bryanduxbury/charlieclocks/(list of files, cad)

Other CAD files:
radiata/v1/enclosure_v1.scad
