bryanduxbury/charlieclocks/radiata/v2/prog_adapter.brd

## EAGLE design radiata/v2/prog_adapter.brd (2013-12-31)

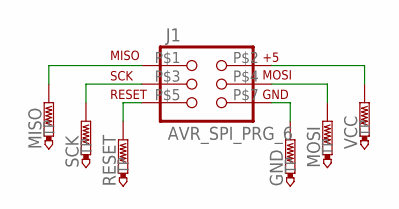
[picture p1: schematic prog_adapter.sch]

Parts:
GND: PTR1PAD1-17; P1-17
J1: AVR_SPI_PRG_6; 2X3_ICSP_SMD
MISO: PTR1PAD1-17; P1-17
MOSI: PTR1PAD1-17; P1-17
RESET: PTR1PAD1-17; P1-17
SCK: PTR1PAD1-17; P1-17
VCC: PTR1PAD1-17; P1-17

Connections:
unnamed: J1.P$1 (1), MISO.TP
unnamed: J1.P$3 (3), SCK.TP
unnamed: J1.P$5 (5), RESET.TP
unnamed: J1.P$2 (2), VCC.TP
unnamed: J1.P$4 (4), MOSI.TP
unnamed: GND.TP, J1.P$7 (6)

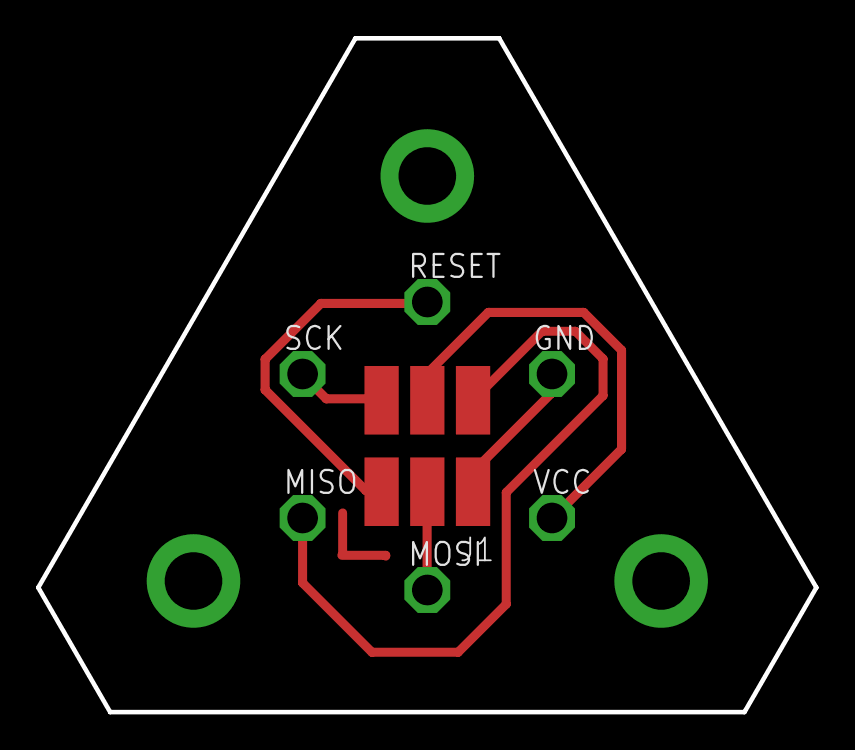
[picture p2: board prog_adapter.brd from above]

Board: 2 copper layers, 43.2 x 37.4 mm, 7 parts (0 on the bottom side), 6 nets.
