bryanduxbury/charlieclocks/radiata/v2/radiata_v2.brd

## EAGLE design radiata/v2/radiata_v2.brd (2014-02-02)

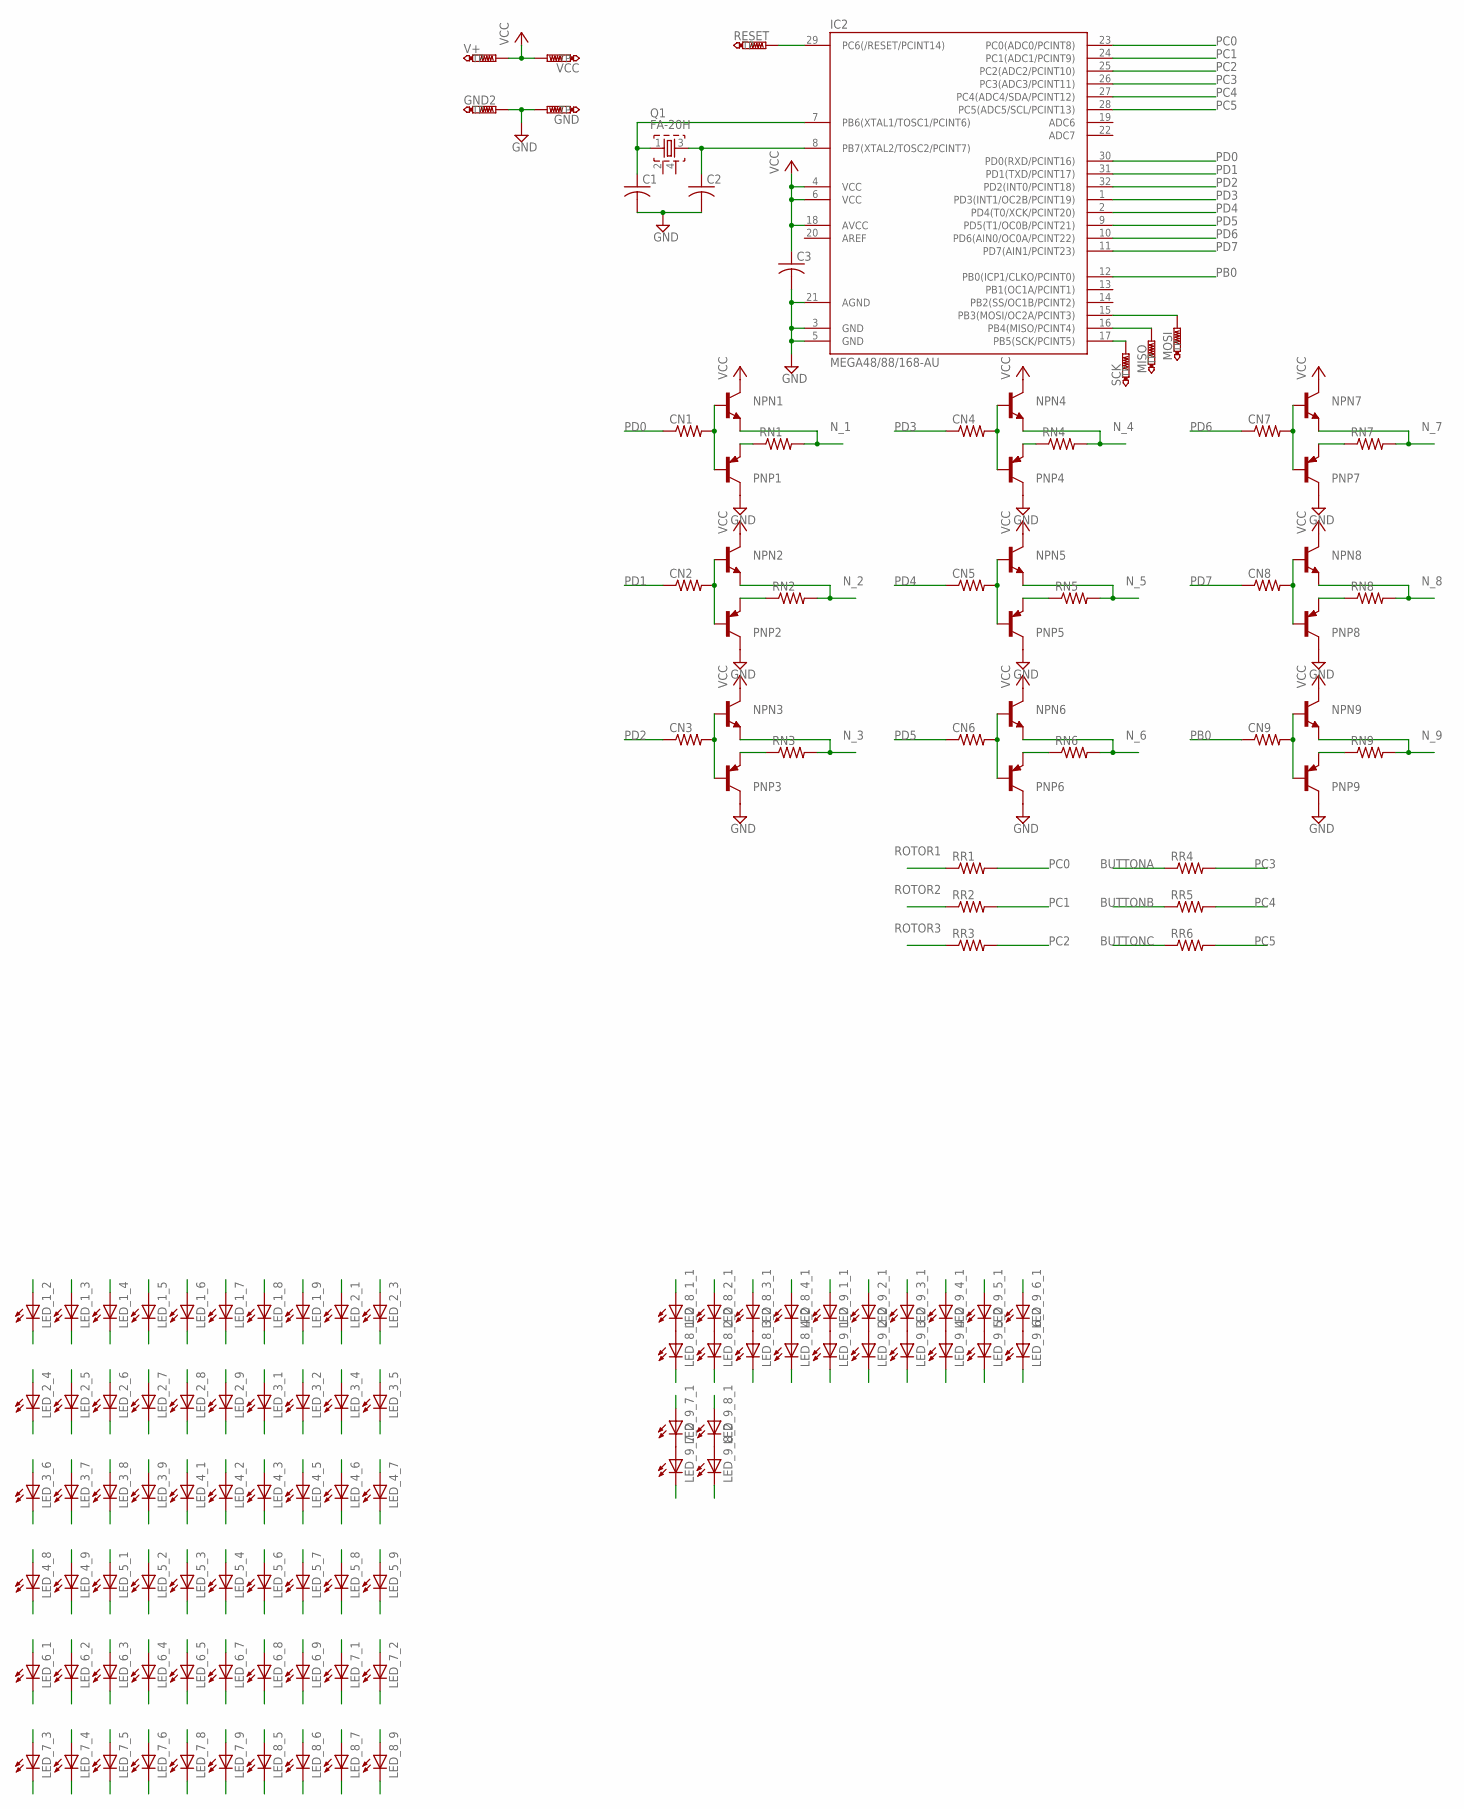
[picture p3: schematic radiata_v2.sch]

Parts:
C1, C2, C3: C-USC0603; C0603
CN1, CN2, CN3, CN4, CN5, CN6, CN7, CN8, CN9: R-US_M0805; M0805
GND: PTR1TP19R; TP19R
GND2: PTR1TP20SQ; TP20SQ
IC2: MEGA48/88/168-AU; TQFP32-08
LED_1_2, LED_1_3, LED_1_4, LED_1_5, LED_1_6, LED_1_7, LED_1_8, LED_1_9, LED_2_1, LED_2_3, LED_2_4, LED_2_5, LED_2_6, LED_2_7, LED_2_8, LED_2_9, LED_3_1, LED_3_2, LED_3_4, LED_3_5, LED_3_6, LED_3_7, LED_3_8, LED_3_9, LED_4_1, LED_4_2, LED_4_3, LED_4_5, LED_4_6, LED_4_7, LED_4_8, LED_4_9, LED_5_1, LED_5_2, LED_5_3, LED_5_4, LED_5_6, LED_5_7, LED_5_8, LED_5_9, LED_6_1, LED_6_2, LED_6_3, LED_6_4, LED_6_5, LED_6_7, LED_6_8, LED_6_9, LED_7_1, LED_7_2, LED_7_3, LED_7_4, LED_7_5, LED_7_6, LED_7_8, LED_7_9, LED_8_1_1, LED_8_1_2, LED_8_2_1, LED_8_2_2, LED_8_3_1, LED_8_3_2, LED_8_4_1, LED_8_4_2, LED_8_5, LED_8_6, LED_8_7, LED_8_9, LED_9_1_1, LED_9_1_2, LED_9_2_1, LED_9_2_2, LED_9_3_1, LED_9_3_2, LED_9_4_1, LED_9_4_2, LED_9_5_1, LED_9_5_2, LED_9_6_1, LED_9_6_2, LED_9_7_1, LED_9_7_2, LED_9_8_1, LED_9_8_2: LED1206; LED-1206
MISO: PTR1TP19R; TP19R
MOSI: PTR1TP19R; TP19R
NPN1, NPN2, NPN3, NPN4, NPN5, NPN6, NPN7, NPN8, NPN9: MMBT2222ALT1-NPN-SOT23-BEC; SOT23-BEC
PNP1, PNP2, PNP3, PNP4, PNP5, PNP6, PNP7, PNP8, PNP9: MMBT2907ALT1-PNP-SOT23-BEC; SOT23-BEC
Q1: FA-20H
RESET: PTR1TP19R; TP19R
RN1, RN2, RN3, RN4, RN5, RN6, RN7, RN8, RN9: RESISTOR1206; 1206
RR1, RR2, RR3, RR4, RR5, RR6: RESISTOR1206; 1206
SCK: PTR1TP19R; TP19R
V+: PTR1TP20SQ; TP20SQ
VCC: PTR1TP19R; TP19R

Connections:
BUTTONA: RR4.1
BUTTONB: RR5.1
BUTTONC: RR6.1
GND: C1.2, C2.2, C3.2, GND.TP, GND2.TP, IC2.3 (GND), IC2.5 (GND), IC2.21 (AGND), PNP1.C, PNP2.C, PNP3.C, PNP4.C, PNP5.C, PNP6.C, PNP7.C, PNP8.C, PNP9.C
unnamed: IC2.29 (PC6(/RESET/PCINT14)), RESET.TP
unnamed: IC2.17 (PB5(SCK/PCINT5)), SCK.TP
unnamed: IC2.16 (PB4(MISO/PCINT4)), MISO.TP
unnamed: IC2.15 (PB3(MOSI/OC2A/PCINT3)), MOSI.TP
unnamed: PNP1.E, RN1.1
unnamed: CN1.2, NPN1.B, PNP1.B
unnamed: PNP2.E, RN2.1
unnamed: CN2.2, NPN2.B, PNP2.B
unnamed: PNP3.E, RN3.1
unnamed: CN3.2, NPN3.B, PNP3.B
unnamed: PNP4.E, RN4.1
unnamed: CN4.2, NPN4.B, PNP4.B
unnamed: PNP5.E, RN5.1
unnamed: CN5.2, NPN5.B, PNP5.B
unnamed: PNP6.E, RN6.1
unnamed: CN6.2, NPN6.B, PNP6.B
unnamed: C2.1, IC2.8 (PB7(XTAL2/TOSC2/PCINT7)), Q1.3
unnamed: LED_8_1_1.C, LED_8_1_2.A
unnamed: LED_8_2_1.C, LED_8_2_2.A
unnamed: PNP7.E, RN7.1
unnamed: CN7.2, NPN7.B, PNP7.B
unnamed: PNP8.E, RN8.1
unnamed: CN8.2, NPN8.B, PNP8.B
unnamed: PNP9.E, RN9.1
unnamed: CN9.2, NPN9.B, PNP9.B
unnamed: LED_8_3_1.C, LED_8_3_2.A
unnamed: LED_8_4_1.C, LED_8_4_2.A
unnamed: LED_9_1_1.C, LED_9_1_2.A
unnamed: LED_9_2_1.C, LED_9_2_2.A
unnamed: LED_9_3_1.C, LED_9_3_2.A
unnamed: LED_9_4_1.C, LED_9_4_2.A
unnamed: LED_9_5_1.C, LED_9_5_2.A
unnamed: LED_9_6_1.C, LED_9_6_2.A
unnamed: LED_9_7_1.C, LED_9_7_2.A
unnamed: LED_9_8_1.C, LED_9_8_2.A
N_1: LED_1_2.A, LED_1_3.A, LED_1_4.A, LED_1_5.A, LED_1_6.A, LED_1_7.A, LED_1_8.A, LED_1_9.A, LED_2_1.C, LED_3_1.C, LED_4_1.C, LED_5_1.C, LED_6_1.C, LED_7_1.C, LED_8_1_2.C, LED_9_1_2.C, NPN1.E, RN1.2
N_2: LED_1_2.C, LED_2_1.A, LED_2_3.A, LED_2_4.A, LED_2_5.A, LED_2_6.A, LED_2_7.A, LED_2_8.A, LED_2_9.A, LED_3_2.C, LED_4_2.C, LED_5_2.C, LED_6_2.C, LED_7_2.C, LED_8_2_2.C, LED_9_2_2.C, NPN2.E, RN2.2
N_3: LED_1_3.C, LED_2_3.C, LED_3_1.A, LED_3_2.A, LED_3_4.A, LED_3_5.A, LED_3_6.A, LED_3_7.A, LED_3_8.A, LED_3_9.A, LED_4_3.C, LED_5_3.C, LED_6_3.C, LED_7_3.C, LED_8_3_2.C, LED_9_3_2.C, NPN3.E, RN3.2
N_4: LED_1_4.C, LED_2_4.C, LED_3_4.C, LED_4_1.A, LED_4_2.A, LED_4_3.A, LED_4_5.A, LED_4_6.A, LED_4_7.A, LED_4_8.A, LED_4_9.A, LED_5_4.C, LED_6_4.C, LED_7_4.C, LED_8_4_2.C, LED_9_4_2.C, NPN4.E, RN4.2
N_5: LED_1_5.C, LED_2_5.C, LED_3_5.C, LED_4_5.C, LED_5_1.A, LED_5_2.A, LED_5_3.A, LED_5_4.A, LED_5_6.A, LED_5_7.A, LED_5_8.A, LED_5_9.A, LED_6_5.C, LED_7_5.C, LED_8_5.C, LED_9_5_2.C, NPN5.E, RN5.2
N_6: LED_1_6.C, LED_2_6.C, LED_3_6.C, LED_4_6.C, LED_5_6.C, LED_6_1.A, LED_6_2.A, LED_6_3.A, LED_6_4.A, LED_6_5.A, LED_6_7.A, LED_6_8.A, LED_6_9.A, LED_7_6.C, LED_8_6.C, LED_9_6_2.C, NPN6.E, RN6.2
N_7: LED_1_7.C, LED_2_7.C, LED_3_7.C, LED_4_7.C, LED_5_7.C, LED_6_7.C, LED_7_1.A, LED_7_2.A, LED_7_3.A, LED_7_4.A, LED_7_5.A, LED_7_6.A, LED_7_8.A, LED_7_9.A, LED_8_7.C, LED_9_7_2.C, NPN7.E, RN7.2
N_8: LED_1_8.C, LED_2_8.C, LED_3_8.C, LED_4_8.C, LED_5_8.C, LED_6_8.C, LED_7_8.C, LED_8_1_1.A, LED_8_2_1.A, LED_8_3_1.A, LED_8_4_1.A, LED_8_5.A, LED_8_6.A, LED_8_7.A, LED_8_9.A, LED_9_8_2.C, NPN8.E, RN8.2
N_9: LED_1_9.C, LED_2_9.C, LED_3_9.C, LED_4_9.C, LED_5_9.C, LED_6_9.C, LED_7_9.C, LED_8_9.C, LED_9_1_1.A, LED_9_2_1.A, LED_9_3_1.A, LED_9_4_1.A, LED_9_5_1.A, LED_9_6_1.A, LED_9_7_1.A, LED_9_8_1.A, NPN9.E, RN9.2
PB0: CN9.1, IC2.12 (PB0(ICP1/CLKO/PCINT0))
PB1: C1.1, IC2.7 (PB6(XTAL1/TOSC1/PCINT6)), Q1.1
PC0: IC2.23 (PC0(ADC0/PCINT8)), RR1.2
PC1: IC2.24 (PC1(ADC1/PCINT9)), RR2.2
PC2: IC2.25 (PC2(ADC2/PCINT10)), RR3.2
PC3: IC2.26 (PC3(ADC3/PCINT11)), RR4.2
PC4: IC2.27 (PC4(ADC4/SDA/PCINT12)), RR5.2
PC5: IC2.28 (PC5(ADC5/SCL/PCINT13)), RR6.2
PD0: CN1.1, IC2.30 (PD0(RXD/PCINT16))
PD1: CN2.1, IC2.31 (PD1(TXD/PCINT17))
PD2: CN3.1, IC2.32 (PD2(INT0/PCINT18))
PD3: CN4.1, IC2.1 (PD3(INT1/OC2B/PCINT19))
PD4: CN5.1, IC2.2 (PD4(T0/XCK/PCINT20))
PD5: CN6.1, IC2.9 (PD5(T1/OC0B/PCINT21))
PD6: CN7.1, IC2.10 (PD6(AIN0/OC0A/PCINT22))
PD7: CN8.1, IC2.11 (PD7(AIN1/PCINT23))
ROTOR1: RR1.1
ROTOR2: RR2.1
ROTOR3: RR3.1
VCC: C3.1, IC2.4 (VCC), IC2.6 (VCC), IC2.18 (AVCC), NPN1.C, NPN2.C, NPN3.C, NPN4.C, NPN5.C, NPN6.C, NPN7.C, NPN8.C, NPN9.C, V+.TP, VCC.TP

Board: 2 copper layers, 139 parts (15 on the bottom side), 62 nets, no tracks yet.
