bryanduxbury/charlieclocks/simpleclock_v1.brd

## EAGLE design simpleclock_v1.brd (2013-11-09)

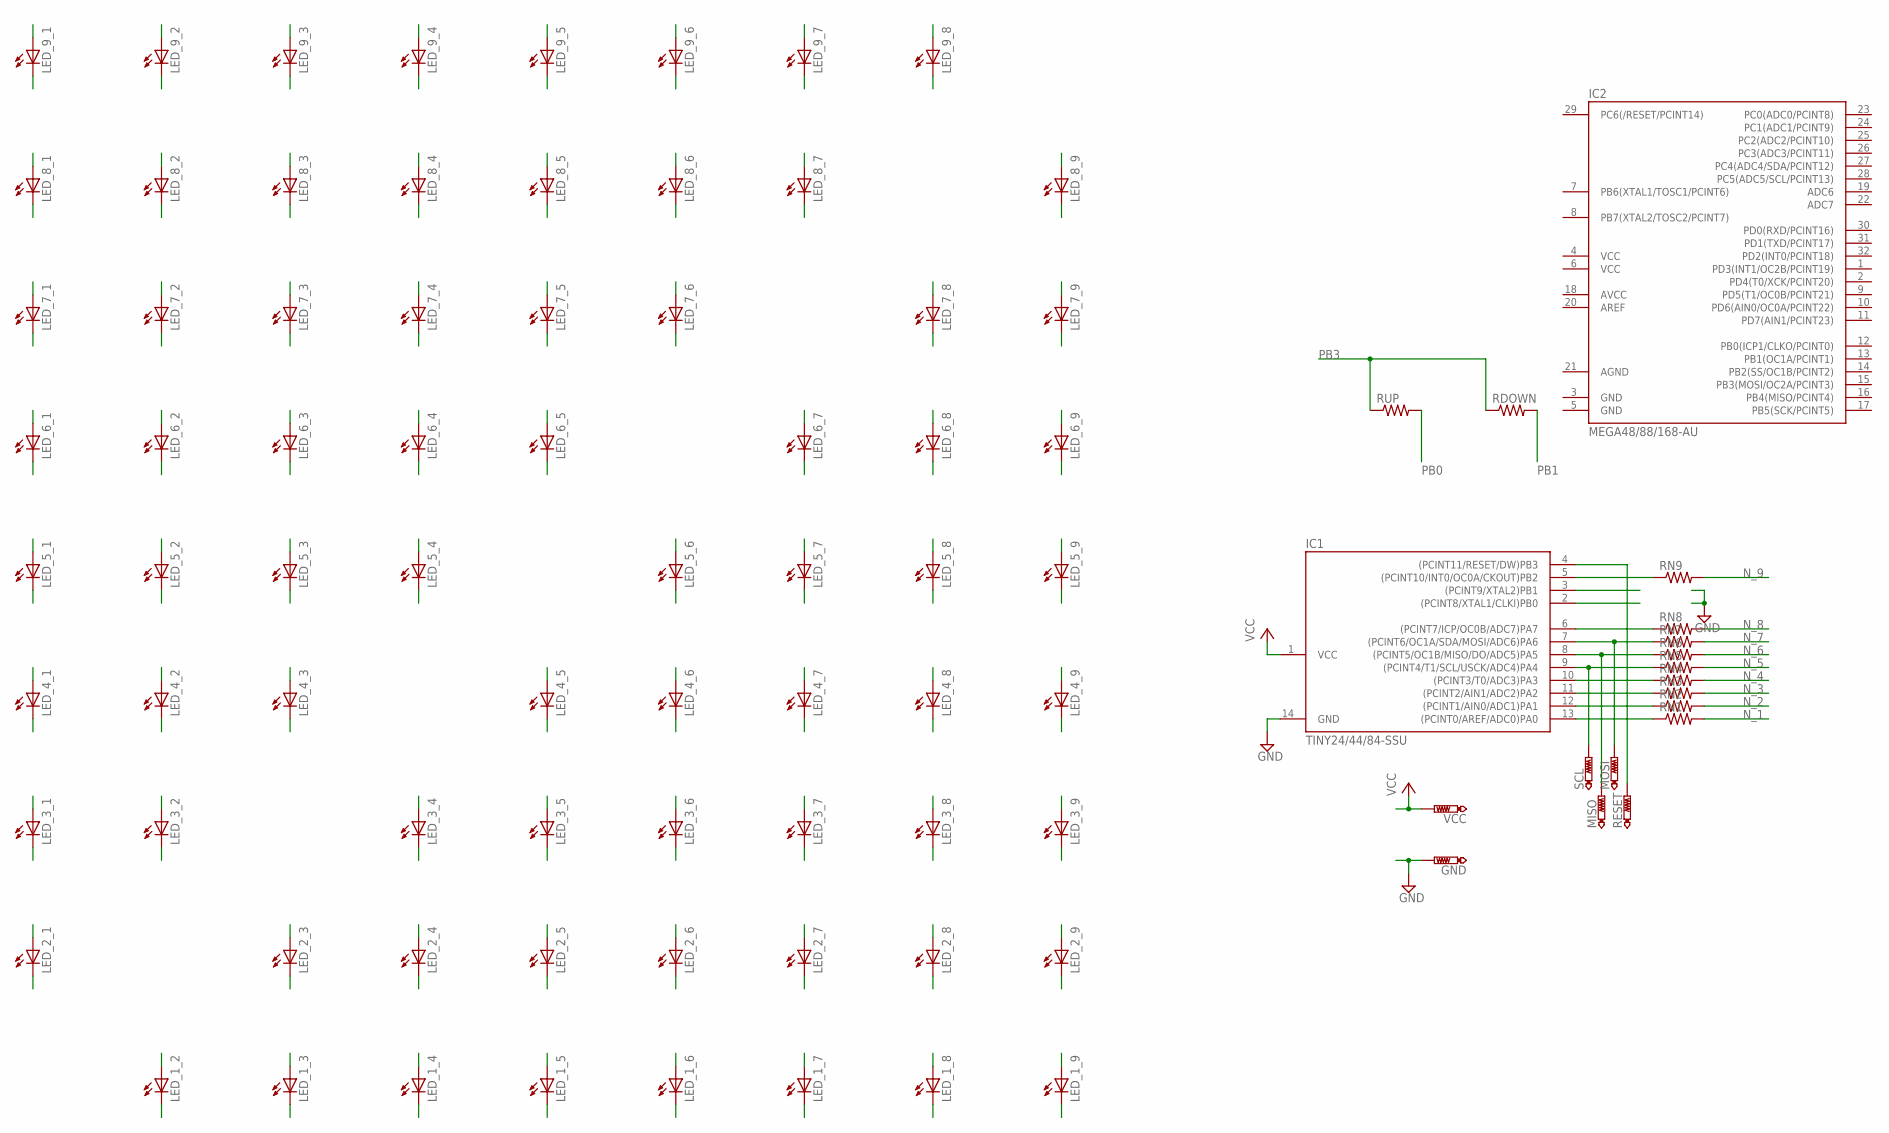
[picture p4: schematic simpleclock_v1.sch]

Parts:
GND: PTR1PAD1-13; P1-13
IC1: TINY24/44/84-SSU; SOIC14
IC2: MEGA48/88/168-AU; TQFP32-08
LED_1_2, LED_1_3, LED_1_4, LED_1_5, LED_1_6, LED_1_7, LED_1_8, LED_1_9, LED_2_1, LED_2_3, LED_2_4, LED_2_5, LED_2_6, LED_2_7, LED_2_8, LED_2_9, LED_3_1, LED_3_2, LED_3_4, LED_3_5, LED_3_6, LED_3_7, LED_3_8, LED_3_9, LED_4_1, LED_4_2, LED_4_3, LED_4_5, LED_4_6, LED_4_7, LED_4_8, LED_4_9, LED_5_1, LED_5_2, LED_5_3, LED_5_4, LED_5_6, LED_5_7, LED_5_8, LED_5_9, LED_6_1, LED_6_2, LED_6_3, LED_6_4, LED_6_5, LED_6_7, LED_6_8, LED_6_9, LED_7_1, LED_7_2, LED_7_3, LED_7_4, LED_7_5, LED_7_6, LED_7_8, LED_7_9, LED_8_1, LED_8_2, LED_8_3, LED_8_4, LED_8_5, LED_8_6, LED_8_7, LED_8_9, LED_9_1, LED_9_2, LED_9_3, LED_9_4, LED_9_5, LED_9_6, LED_9_7, LED_9_8: LEDCHIPLED_1206; CHIPLED_1206
MISO: PTR1PAD1-13; P1-13
MOSI: PTR1PAD1-13; P1-13
RDOWN: RESISTOR1206; 1206
RESET: PTR1PAD1-13; P1-13
RN1, RN2, RN3, RN4, RN5, RN6, RN7, RN8, RN9: RESISTOR1206; 1206
RUP: RESISTOR1206; 1206
SCL: PTR1PAD1-13; P1-13
VCC: PTR1PAD1-13; P1-13

Connections:
AGND: IC2.21 (AGND)
GND: GND.TP, IC1.14 (GND), IC2.3 (GND), IC2.5 (GND)
N_1: LED_1_2.A, LED_1_3.A, LED_1_4.A, LED_1_5.A, LED_1_6.A, LED_1_7.A, LED_1_8.A, LED_1_9.A, LED_2_1.C, LED_3_1.C, LED_4_1.C, LED_5_1.C, LED_6_1.C, LED_7_1.C, LED_8_1.C, LED_9_1.C, RN1.2
N_2: LED_1_2.C, LED_2_1.A, LED_2_3.A, LED_2_4.A, LED_2_5.A, LED_2_6.A, LED_2_7.A, LED_2_8.A, LED_2_9.A, LED_3_2.C, LED_4_2.C, LED_5_2.C, LED_6_2.C, LED_7_2.C, LED_8_2.C, LED_9_2.C, RN2.2
N_3: LED_1_3.C, LED_2_3.C, LED_3_1.A, LED_3_2.A, LED_3_4.A, LED_3_5.A, LED_3_6.A, LED_3_7.A, LED_3_8.A, LED_3_9.A, LED_4_3.C, LED_5_3.C, LED_6_3.C, LED_7_3.C, LED_8_3.C, LED_9_3.C, RN3.2
N_4: LED_1_4.C, LED_2_4.C, LED_3_4.C, LED_4_1.A, LED_4_2.A, LED_4_3.A, LED_4_5.A, LED_4_6.A, LED_4_7.A, LED_4_8.A, LED_4_9.A, LED_5_4.C, LED_6_4.C, LED_7_4.C, LED_8_4.C, LED_9_4.C, RN4.2
N_5: LED_1_5.C, LED_2_5.C, LED_3_5.C, LED_4_5.C, LED_5_1.A, LED_5_2.A, LED_5_3.A, LED_5_4.A, LED_5_6.A, LED_5_7.A, LED_5_8.A, LED_5_9.A, LED_6_5.C, LED_7_5.C, LED_8_5.C, LED_9_5.C, RN5.2
N_6: LED_1_6.C, LED_2_6.C, LED_3_6.C, LED_4_6.C, LED_5_6.C, LED_6_1.A, LED_6_2.A, LED_6_3.A, LED_6_4.A, LED_6_5.A, LED_6_7.A, LED_6_8.A, LED_6_9.A, LED_7_6.C, LED_8_6.C, LED_9_6.C, RN6.2
N_7: LED_1_7.C, LED_2_7.C, LED_3_7.C, LED_4_7.C, LED_5_7.C, LED_6_7.C, LED_7_1.A, LED_7_2.A, LED_7_3.A, LED_7_4.A, LED_7_5.A, LED_7_6.A, LED_7_8.A, LED_7_9.A, LED_8_7.C, LED_9_7.C, RN7.2
N_8: LED_1_8.C, LED_2_8.C, LED_3_8.C, LED_4_8.C, LED_5_8.C, LED_6_8.C, LED_7_8.C, LED_8_1.A, LED_8_2.A, LED_8_3.A, LED_8_4.A, LED_8_5.A, LED_8_6.A, LED_8_7.A, LED_8_9.A, LED_9_8.C, RN8.2
N_9: LED_1_9.C, LED_2_9.C, LED_3_9.C, LED_4_9.C, LED_5_9.C, LED_6_9.C, LED_7_9.C, LED_8_9.C, LED_9_1.A, LED_9_2.A, LED_9_3.A, LED_9_4.A, LED_9_5.A, LED_9_6.A, LED_9_7.A, LED_9_8.A, RN9.2
PA0: IC1.13 ((PCINT0/AREF/ADC0)PA0), RN1.1
PA1: IC1.12 ((PCINT1/AIN0/ADC1)PA1), RN2.1
PA2: IC1.11 ((PCINT2/AIN1/ADC2)PA2), RN3.1
PA3: IC1.10 ((PCINT3/T0/ADC3)PA3), RN4.1
PA4: IC1.9 ((PCINT4/T1/SCL/USCK/ADC4)PA4), RN5.1, SCL.TP
PA5: IC1.8 ((PCINT5/OC1B/MISO/DO/ADC5)PA5), MISO.TP, RN6.1
PA6: IC1.7 ((PCINT6/OC1A/SDA/MOSI/ADC6)PA6), MOSI.TP, RN7.1
PA7: IC1.6 ((PCINT7/ICP/OC0B/ADC7)PA7), RN8.1
PB0: IC1.2 ((PCINT8/XTAL1/CLKI)PB0), RUP.2
PB1: IC1.3 ((PCINT9/XTAL2)PB1), RDOWN.2
PB2: IC1.5 ((PCINT10/INT0/OC0A/CKOUT)PB2), RN9.1
PB3: IC1.4 ((PCINT11/RESET/DW)PB3), RDOWN.1, RESET.TP, RUP.1
VCC: IC1.1 (VCC), IC2.4 (VCC), IC2.6 (VCC), VCC.TP

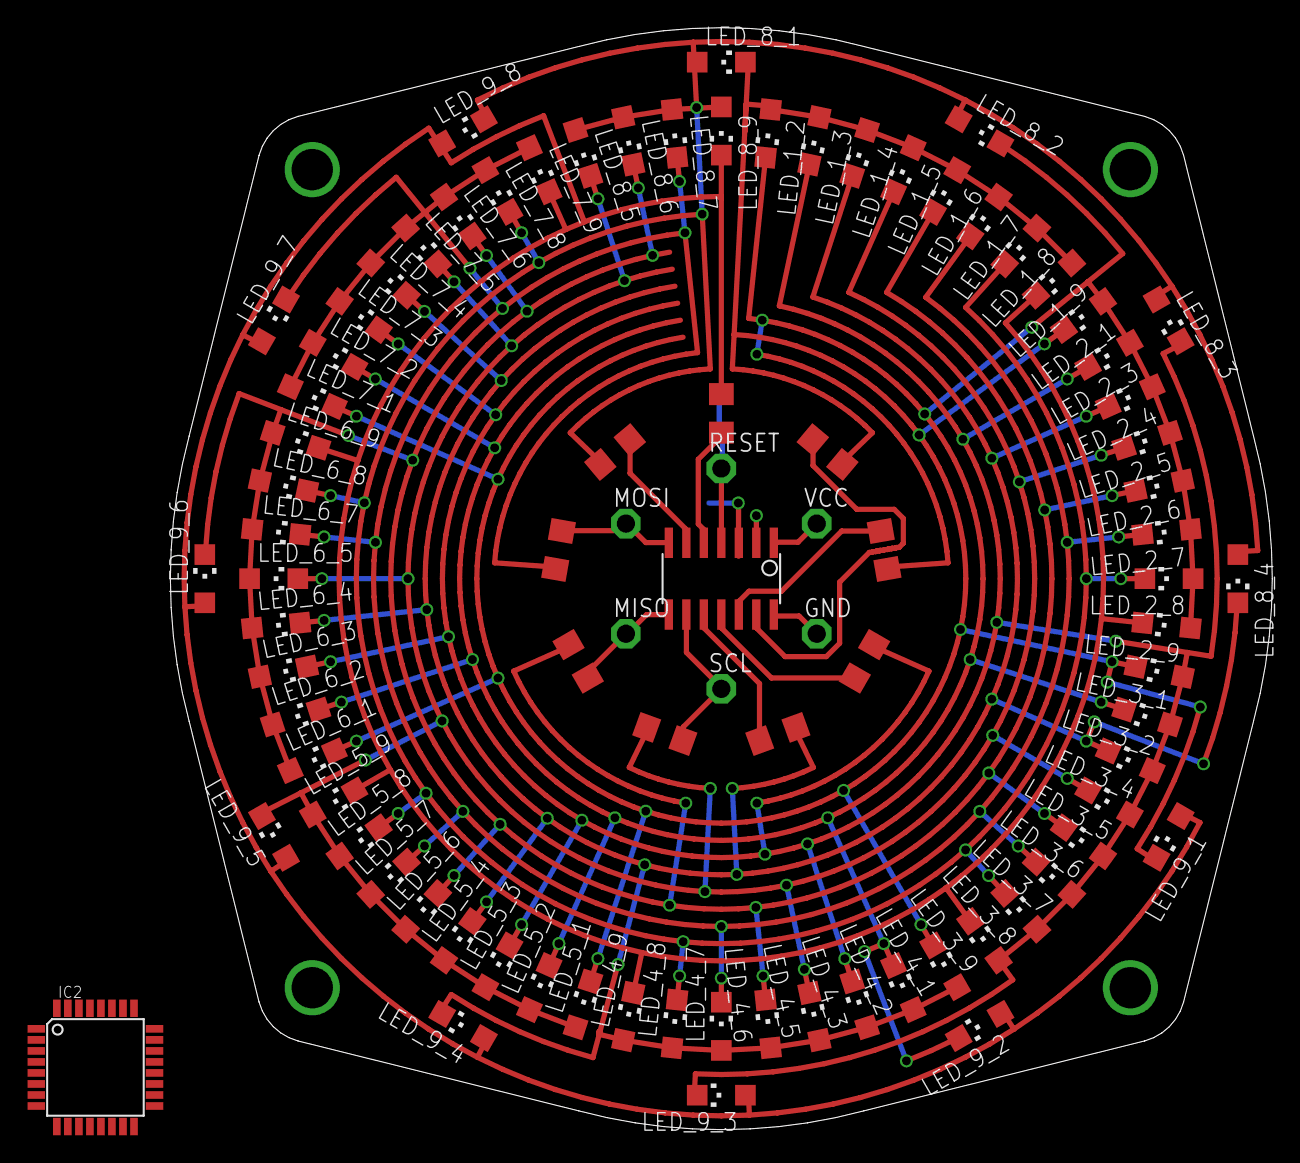
[picture p5: board simpleclock_v1.brd from above]

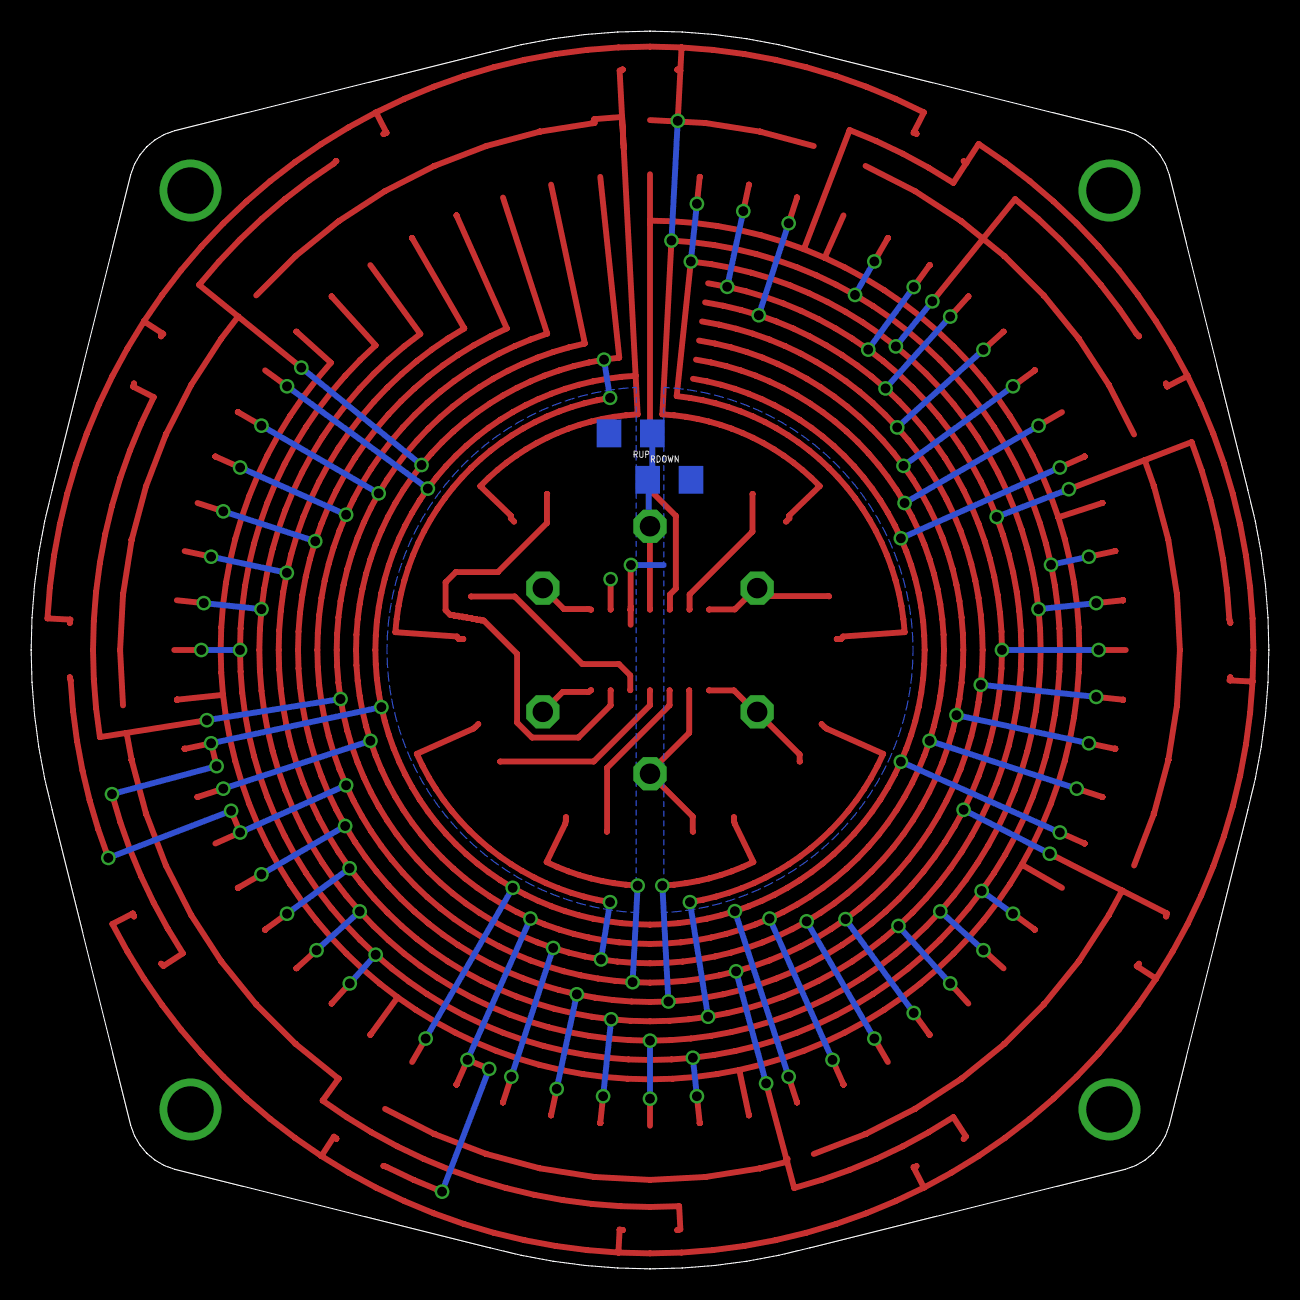
[picture p6: board simpleclock_v1.brd from below]

Board: 2 copper layers, 80.0 x 80.0 mm, 91 parts (2 on the bottom side), 23 nets.
