bryanduxbury/charlieclocks/(commit log)

2013-09-09 init commit (finally)
    [simpleclock_v1.brd, simpleclock_v1.sch]
2013-09-10 lots more traces routed
    [simpleclock_v1.brd]
2013-09-22 wow, it's been that long since i committed?
    [simpleclock_v1.brd, simpleclock_v1.sch]
2013-11-09 new board outline
    [outline.scad, simpleclock_v1.brd, simpleclock_v1.sch]
2013-11-15 reroute the outer leds so that the scroll rotor can fit into the space under the inner leds
    [scroll_wheel.scad]
2013-11-15 fix a routing issue; adjust scroll rotor size
    [radiata_v1.brd, scroll_wheel.scad]
2013-11-17 lots of progress, driving towards a scroll wheel that passes DRC
    [radiata_v1.brd, radiata_v1.sch, scroll_wheel.scad]
2013-11-27 add push/pull resistors
    [radiata_v1.brd, radiata_v1.sch, scroll_wheel.scad]
2013-12-06 some cleanup in the scroll wheel scad
    [scroll_wheel.scad]
2013-12-06 final versions of board and schematic
    [radiata_v1.brd, radiata_v1.sch]
2013-12-06 move all the radiata stuff down a level into their own folder
    [outline.scad, radiata_v1.brd, radiata_v1.sch, scroll_wheel.scad]
2013-12-07 added design for programming adapter
    [prog_adapter.brd, prog_adapter.sch]
2013-12-18 mocked pcba scad model to design around
    [pcba_mockup.scad]
2013-12-18 misc changes to programming adapter board
    [prog_adapter.brd]
2013-12-18 added programming points to the pcba mockup; first rev of assembled enclosure
    [enclosure_v1.scad, pcba_mockup.scad]
2013-12-29 wip for enclosure + stand
    [enclosure_v1.scad]
2013-12-29 fix the programming adapter board to actually mate with the real pcb
    [prog_adapter.brd]
2013-12-31 fix the prog adapter board to actually match the correct pinout
    [prog_adapter.brd]
2014-01-05 added the suppress method to MonoCap; didn't make a huge difference :(
    [MonoCap.cpp, MonoCap.h, MonoCapWheel.cpp, firmware.ino]
2014-01-15 almost done with the enclosure
    [enclosure_v1.scad]
2014-01-16 add tabs to stand sides and back retainer
    [enclosure_v1.scad]
2014-01-16 kerf adjust the stand side piece
    [enclosure_v1.scad]
2014-01-18 add top level time-based-rotate for animated giffing
    [enclosure_v1.scad]
2014-02-02 move all the v1 files into v1 dir
    [enclosure_v1.scad, outline.scad, pcba_mockup.scad, prog_adapter.brd, prog_adapter.sch, radiata_v1.brd, radiata_v1.sch, scroll_wheel.scad]
2014-02-02 thicken the midring and adjust screw hole sizes
    [enclosure_v1.scad]
2014-02-03 clean out exported dxfs
    [back.dxf, back_retainer.dxf, face.dxf, face_retainer.dxf, mid_ring.dxf, stand_bottom.dxf, stand_side.dxf, suspended_enclosure_v1.dxf]
2014-02-03 replace a bunch of constants with variables
    [enclosure_v1.scad]
2014-02-27 fix the firmware to actually keep decent time; tested-working version of the programming remote
    [prog_adapter.brd]
